wikihouseproject/Owl/Owl_BOM.xlsx.xlsx

Owl
Date | 2017-01-26
Country | UK
Client | None
Team | Architecture 00
Status | Prototype
MATERIAL |  |  | SqM |  |  | Units |  |  | Cost |  | Status
Item | Specification | Suggested | SqM / M required | £ per SqM | Sub total cost | # Units per M, SqM or CuM | Total # Units | £ per Unit | TOTAL £ | VAT @ 20%
SUB TOTAL
Birch-faced ply | WISA Twin birch faced, 1220x2440x18 | http://www.lathamtimber.co.uk/downloads/james-latham-product-price-guide-65.pdf |  |  |  |  | 3 | £43.10 | £129.30
Dowels | 8mm x 30mm | http://www.diy.com/departments/bq-dowel-8mm-x-30mm-pack-of-25/243300_BQ.prd |  |  |  |  | 1 | 1.82 | £1.82
 |  |  |  |  |  |  |  |  | £131.12 | £26.22
IRONMONGERY
Hinges | 102x75x3mm | http://www.diy.com/departments/stainless-steel-grade-11-ball-bearing-hinge-pair-of-2/29418_BQ.prd |  |  |  |  | 1.5 | £7.02 | £10.53 | £1.40
Tubular latch | 80mm, steel with | http://www.diy.com/departments/bq-tubular-latch-l80mm/171955_BQ.prd |  |  |  |  | 1 | £3.19 | £3.19 | £0.64
Handle set | Brushed stainless steel | http://www.diy.com/departments/bq-satin-stainless-steel-effect-straight-internal-external-lever-latch-door-handle-pack-of-2/190881_BQ.prd |  |  |  |  | 1 | £14.17 | £14.17 | £2.83
SUB TOTAL |  |  |  |  |  |  |  |  | £27.89
TREATMENT
Osmo Oil | Raw, 775ml | http://www.wood-finishes-direct.com/product/osmo-polyx-oil-raw-3044?gclid=CLDHtePG39ECFUK7Gwod3Z8EqQ |  |  |  |  | 1 | £6.99 | £6.99 | £1.40
SUB TOTAL |  |  |  |  |  |  |  |  | £6.99 | £1.40
MATERIALS TOTAL |  |  |  |  |  |  |  |  | £166.00 | £33.20
PRODUCTION COSTS
CNC cutting | CNC per sheet |  |  |  |  |  | 3 | £25.00 | £75.00
Sanding
Delivery
Installation
 |  |  |  |  |  |  |  |  | £75.00
PROJECT TOTAL |  |  |  |  |  |  |  |  | £241.00 | £48.20
