wikihouseproject/Owl/(list of files, cad)

Other CAD files:
Owl_2_CuttingFiles.dxf
