wikihouseproject/Owl/Owl_Manual.pdf

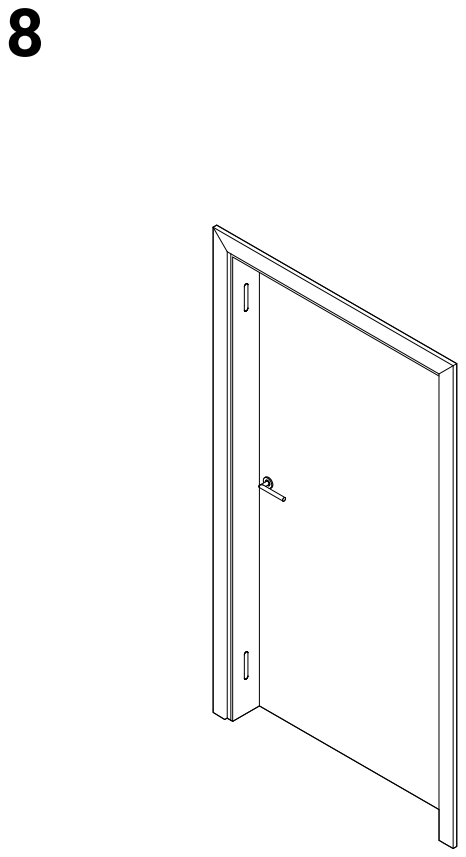
[picture p8: page 8]
